BLEduino/bleduino-big-board/README.md

Big-Board
=========

The BLEduinos test board used to verify and test the individual components on the final BLEduino.
