BLEduino/bleduino-big-board/Bill of Materials/BOM_Big_Board.xlsx

Part | Part # | Leads | Total Leads | Package | Quantity | Web Links
100nF Capacitor | 445-4711-1-ND | 2 | 14 | 603 | 7 | http://www.digikey.com/product-detail/en/CL10F104ZA8NNNC/1276-1011-1-ND/3889097
10k Resistor | P10KGCT-ND | 2 | 12 | 603 | 6 | www.digikey.com/product-detail/en/ERJ-3GEYJ103V/P10KGCT-ND/134717
Ferrite Bead | MH2029-300YCT-ND | 2 | 2 | 805 | 1 | http://www.digikey.com/product-detail/en/MH2029-300Y/MH2029-300YCT-ND/3741761
ESD Protector | CG0603MLC-05E | 2 | 4 | 603 | 2 | www.digikey.com/product-detail/en/CG0603MLC-05E/CG0603MLC-05ECT-ND/3438061
1uF Capacitor | 445-5146-1-ND | 2 | 10 | 603 | 5 | www.digikey.com/product-detail/en/C1608X5R1E105K080AC/445-5146-1-ND/2093761
1k Resistor | P1.0KGCT-ND | 2 | 8 | 603 | 4 | www.digikey.com/product-detail/en/ERJ-3GEYJ102V/P1.0KGCT-ND/134874
22pF Capacitor | 445-1273-1-ND | 2 | 14 | 603 | 7 | http://www.digikey.com/product-detail/en/C1608C0G1H220J080AA/445-1273-1-ND/567670
15pF Capacitor | 399-8948-1-ND | 2 | 4 | 402 | 2 | www.digikey.com/product-detail/en/C0402C150K5GACTU/399-8948-1-ND/3522465
12pF Capacitor | 311-1016-1-ND | 2 | 4 | 402 | 2 | http://www.digikey.com/product-detail/en/CC0402JRNPO9BN120/311-1016-1-ND/302933
1nF Capacitor | 445-2651-1-ND | 2 | 2 | 402 | 1 | www.digikey.com/product-detail/en/C1005C0G1E102J050BA/445-2651-1-ND/970476
22 Ohms | P22GCT-ND | 2 | 4 | 603 | 2 | http://www.digikey.com/product-detail/en/ERJ-3GEYJ220V/P22GCT-ND/134662
22k Resistor | P22.0KLCT-ND | 2 | 2 | 402 | 1 | www.digikey.com/product-detail/en/ERJ-2RKF2202X/P22.0KLCT-ND/1746653
1.2pF Capacitor | 1276-1652-6-ND | 2 | 2 | 402 | 1 | www.digikey.com/product-detail/en/CL05C1R2BB5NNNC/1276-1652-6-ND/3892166
1.8pF Capacitor | 712-1271-1-ND | 2 | 2 | 402 | 1 | www.digikey.com/product-detail/en/500R07S1R8BV4T/712-1271-1-ND/1786733
2.2pF Capacitor | 399-7782-1-ND | 2 | 2 | 402 | 1 | www.digikey.com/product-detail/en/C0402C229C5GACTU/399-7782-1-ND/3471505
33nF Capacitor | 445-6896-1-ND | 2 | 2 | 402 | 1 | www.digikey.com/product-detail/en/CGA2B3X7R1H333K050BB/445-6896-1-ND/2672914
100nF Capacitor | 445-4965-2-ND | 2 | 4 | 402 | 2 | http://www.digikey.com/product-detail/en/C1005X5R1E104M050BC/445-4965-1-ND/2093579
10k Resistor | P10.0KLCT-ND | 2 | 6 | 402 | 3 | www.digikey.com/product-detail/en/ERJ-2RKF1002X/P10.0KLCT-ND/194119
20k Resistor | P20.0KLCT-ND | 2 | 6 | 402 | 3 | www.digikey.com/product-detail/en/ERJ-2RKF2002X/P20.0KLCT-ND/194250
3.9nH Inductor | 445-1462-1-ND | 2 | 2 | 402 | 1 | www.digikey.com/product-detail/en/MLK1005S3N9S/445-1462-1-ND/571770
8.2nH Inductor | 445-3057-1-ND | 2 | 2 | 402 | 1 | www.digikey.com/product-detail/en/MLG1005S8N2J/445-3057-1-ND/1132698
5.6nH Inductor | 445-3053-1-ND | 2 | 2 | 402 | 1 | www.digikey.com/product-detail/en/MLG1005S5N6S/445-3053-1-ND/1132694
15nH Inductor | 445-1469-1-ND | 2 | 2 | 402 | 1 | www.digikey.com/product-detail/en/MLK1005S15NJ/445-1469-1-ND/571777
10nH Inductor | 445-3059-1-ND | 2 | 2 | 402 | 1 | www.digikey.com/product-detail/en/MLG1005S10NJ/445-3059-1-ND/1132700
22uF Capacitor | 718-1139-1-ND | 2 | 4 | 1206 | 2 | www.digikey.com/product-detail/en/293D226X96R3A2TE3/718-1139-1-ND/1559633
PMOS Transistor | PMV48XP | 3 | 6 | SOT-23 | 2 | www.digikey.com/product-detail/en/PMV48XP,215/568-7579-1-ND/2744665
5V Voltage Regulator | 576-2770-1-ND | 5 | 5 | SOT-23 | 1 | http://www.digikey.com/product-detail/en/NCP1117ST50T3G/NCP1117ST50T3GOSCT-ND/1967217
3.3V Voltage Regulator | 576-1281-1-ND | 5 | 5 | SOT-23 | 1 | www.digikey.com/product-detail/en/LP2985-33DBVR/296-18476-1-ND/809911
16Mhz Oscillator Crystal | 644-1182-1-ND | 4 | 16 |  | 4 | http://www.digikey.com/product-detail/en/NX3225SA-16MHZ-STD-CSR-3/644-1181-1-ND/3125570
32Mhz Oscillator Crystal | 535-9538-1-ND | 2 | 2 |  | 1 | www.digikey.com/product-detail/en/ABS10-32.768KHZ-9-T/535-9538-1-ND/1237005
Bluetooth Low Energy- nRF8001 | 949-NRF8001-R2Q32-T | 33 | 33 | QFN-32 | 1 | www.mouser.com/ProductDetail/Nordic-Semiconductor/nRF8001-R2Q32-T/
Chip Antenna | 712-ANT-2.45-CHP-T | 2 | 2 |  | 1 | http://www.digikey.com/product-detail/en/ANT-2.45-CHP-T/ANT-2.45-CHPCT-ND/523153
ATTiny84 Microcontroller | ATTINY84A-MMHRCT-ND | 20 | 20 | QFN-20 | 1 | www.digikey.com/product-detail/en/ATTINY84A-MMHR/ATTINY84A-MMHRCT-ND/2774134
ATmega328 Microcontroller | ATMEGA328P-MURCT-ND | 32 | 32 | QFN-32 | 1 | www.digikey.com/product-detail/en/ATMEGA328P-MUR/ATMEGA328P-MURCT-ND/3440953
ATmega32u4 Microcontroller | ATMEGA32U4-MURCT-ND | 44 | 44 | QFN-44 | 1 | www.digikey.com/product-detail/en/ATMEGA32U4-MU/ATMEGA32U4-MU-ND/1914603
PTC Resettable Fuse | MF-MSMF050-2 | 2 | 2 | L1812 | 1 | www.digikey.com/product-detail/en/MF-MSMF050-2/MF-MSMF050-2CT-ND/662842
Micro USB | 609-4613-1-ND | 7 | 7 |  | 1 | www.digikey.com/product-detail/en/10118192-0001LF/609-4613-1-ND/2785378
6mm Reset Switch | CKN10246CT-ND | 4 | 4 | KMR2 | 1 | www.digikey.com/product-detail/en/KMR231NG%20LFS/CKN10246CT-ND/2176497
Diode | PESD1206Q-240CT-ND | 2 | 2 | 1206 | 1 | http://www.digikey.com/product-detail/en/CD1206-S01575/CD1206-S01575CT-ND/3741949
Yellow LED | 160-1448-1-ND | 2 | 4 | CHIPLED_0805 | 2 | www.digikey.com/product-detail/en/LTST-C191KSKT/160-1448-1-ND/386838
Green LED | 160-1446-1-ND | 2 | 2 | CHIPLED_0805 | 1 | www.digikey.com/product-detail/en/LTST-C191KGKT/160-1446-1-ND/386834
Red LED | 160-1447-1-ND | 2 | 2 | CHIPLED_0805 | 1 | www.digikey.com/product-detail/en/LTST-C191KRKT/160-1447-1-ND/386836
