BLEduino/bleduino-big-board/PDFs/BLEduino_Test_Board_brd.pdf

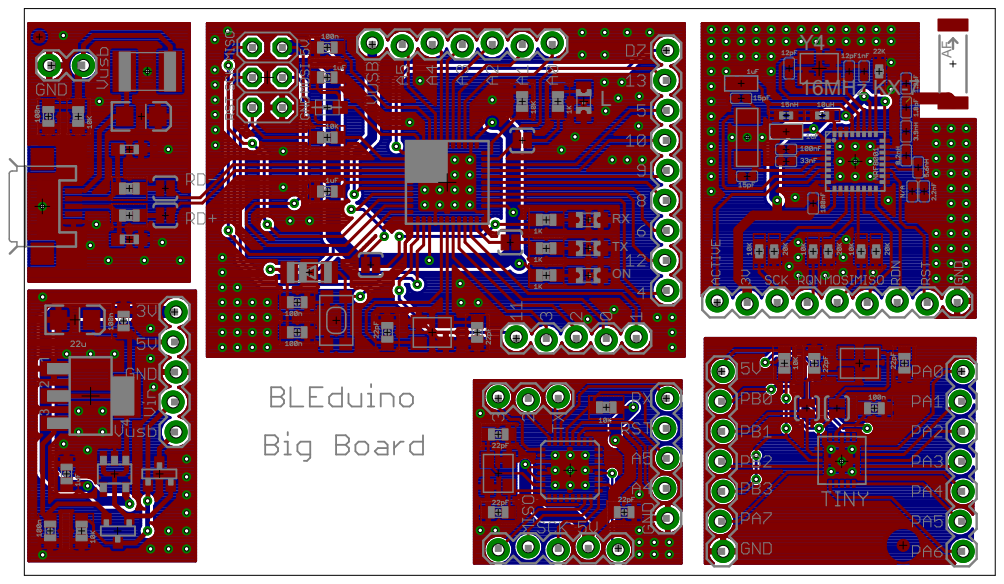
[picture p1: page 1]
