BLEduino/bleduino-big-board/PDFs/BLEduino_Test_Board_sch.pdf

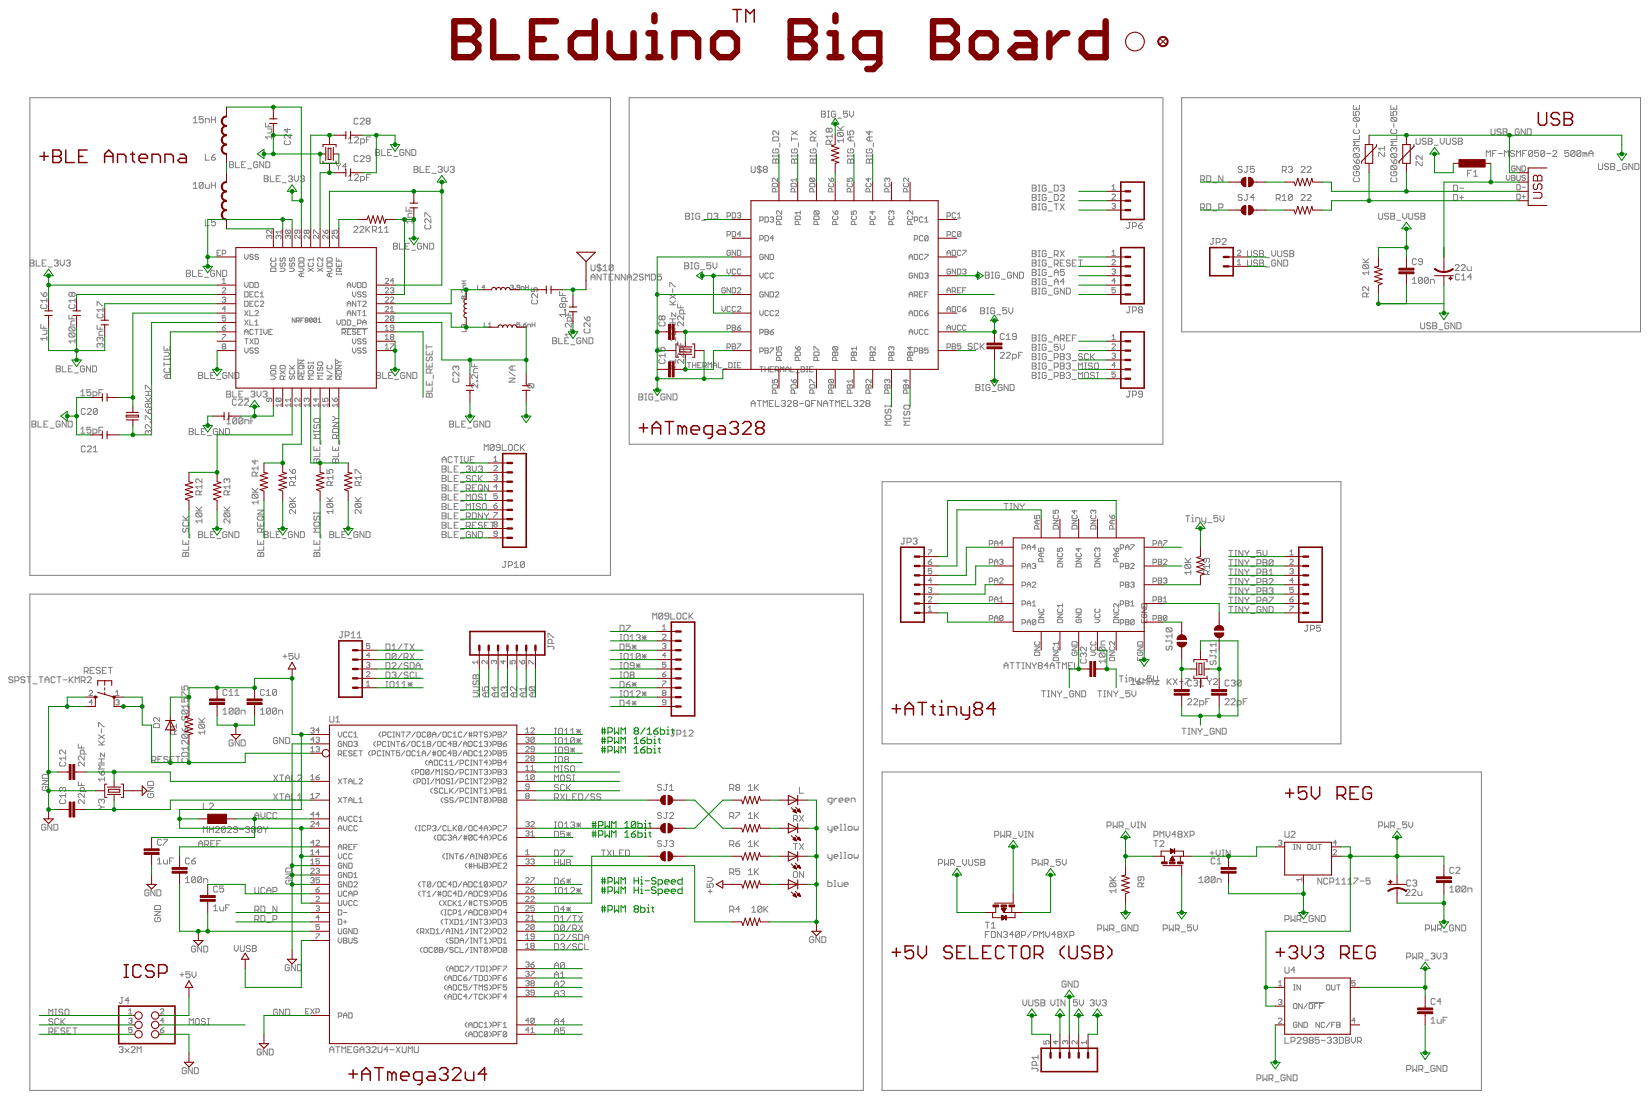
[picture p2: page 1]
