BLEduino/bleduino-big-board/Eagle/BLEduino_Test_Board.brd

## EAGLE design Eagle/BLEduino_Test_Board.brd (2013-10-08)

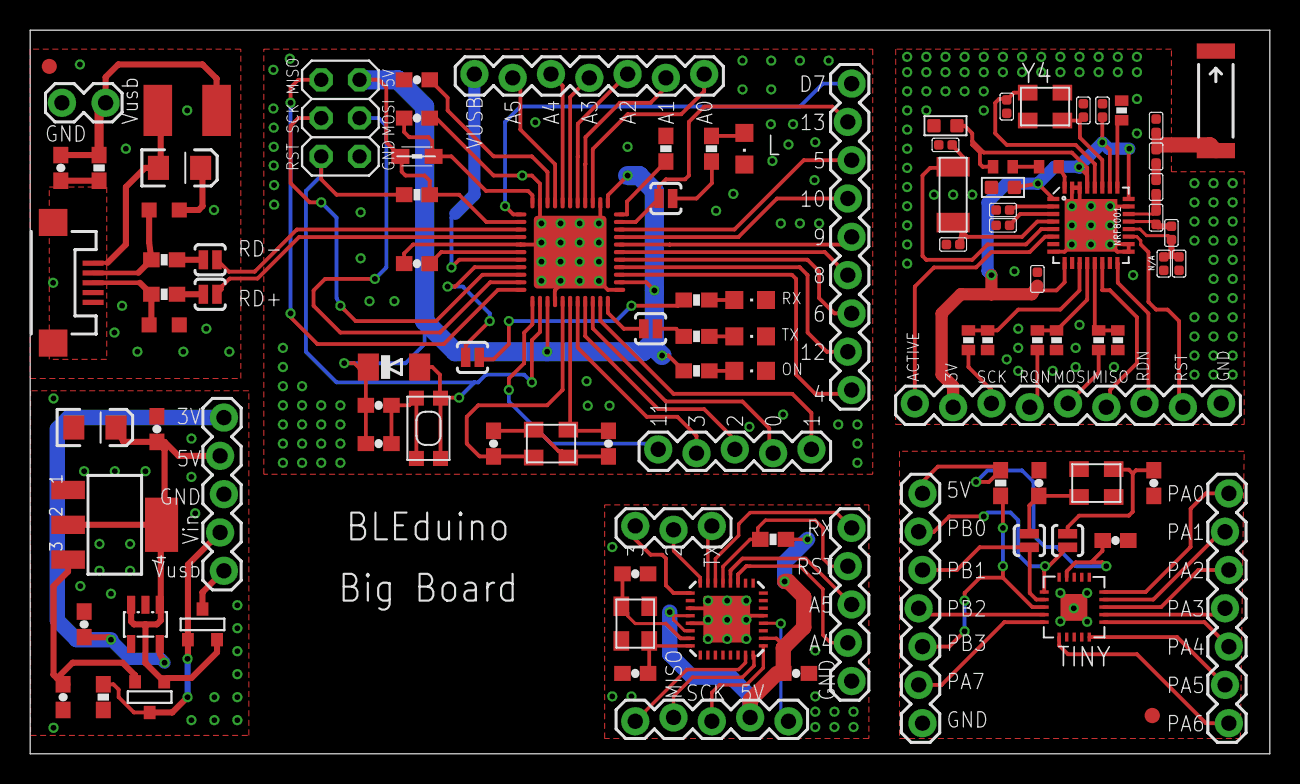
[picture p3: board BLEduino_Test_Board.brd from above]

Board: 4 copper layers, 82.2 x 48.0 mm, 103 parts (0 on the bottom side), 114 nets.

Parts:
32.768KHZ: FITNESSDEVICE_CRYSTAL-ABS10
C1, C2, C6, C9, C10, C11, C32: 100n; 0603-CAP
C3, C14: 22u; EIA3216
C4, C5, C7: 1uF; 0603-CAP
C8, C12, C13, C15, C19, C30, C31: 22pF; 0603-CAP
C16, C24: 1uF; C0603
C17: 33nF; C0402
C18, C22: 100nF; C0402
C20, C21: 15pF; C0402
C23: 2.2nF; C0402
C25: 1.8pF; C0402
C26: 1.2pF; C0402
C27: 1nF; C0402
C28, C29: 12pF; C0402
D2: CD1206-S01575; MINIMELF
F1: MF-MSMF050-2 500mA; L1812
J4: 3x2M; 2X03
JP1, JP8, JP9, JP11: 1X05_LOCK
JP2: 1X02_LOCK
JP3, JP5, JP7: 1X07_LOCK
JP6: 1X03_LOCK
JP10, JP12: M09LOCK; 1X09_LOCK
L: green; CHIPLED_0805
L1: 5.6nH; L0402
L2: MH2029-300Y; 0805
L3: 8.2nH; L0402
L4: 3.9nH; L0402
L5: 10uH; C0402
L6: 15nH; C0402
N/A: 0; C0402
NRF8001: FITNESSDEVICE_NRF8001; FITNESSDEVICE_QFN-32
ON: blue; CHIPLED_0805
R1, R2, R4, R9, R18, R19: 10K; 0603-RES
R3, R10: 22; 0603-RES
R5, R6, R7, R8: 1K; 0603-RES
R11: 22K; 0402-RES
R12, R14, R15: 10K; 0402-RES
R13, R16, R17: 20K; 0402-RES
RESET: SPST_TACT-KMR2; KMR2
RX: yellow; CHIPLED_0805
SJ1, SJ2, SJ3, SJ4, SJ5, SJ10, SJ11: SOLDERJUMPERNO; SJ_2S-NO
T1: FDN340P/PMV48XP; SOT-23
T2: PMV48XP; SOT-23
TINY: ATTINY84ATMEL; ATTINT84-QFN
TX: yellow; CHIPLED_0805
U1: ATMEGA32U4-XUMU; QFN44ML7X7
U2: NCP1117-5; LINEAR_SOT223
U4: LP2985-33DBVR; SOT23-DBV
U$8: ATMEL328-QFNATMEL328; QFN
U$10: ANTENNA2SMD5; ANTENNA-CHIP5
U$37: FIDUCIALMOUNT; FIDUCIA-MOUNT
U$53: FIDUCIAL1X2; FIDUCIAL-1X2
X1: USB-MICROB
Y1, Y2, Y3, Y4: 16MHz KX-7; CRYSTAL-3.2-2.5
Z1, Z2: CG0603MLC-05E; CT/CN0603

Connections:
+5V: C10.1, C11.1, D2.C, J4.2, L2.1, R1.1, R5.1, U1.2, U1.14, U1.24, U1.34
+VIN: C1.1, T2.2, U2.3
A0: JP7.7, U1.36
A1: JP7.6, U1.37
A2: JP7.5, U1.38
A3: JP7.4, U1.39
A4: JP7.3, U1.40
A5: JP7.2, U1.41
ACTIVE: JP10.1, NRF8001.6
AREF: C6.1, U1.42
AVCC: C7.1, L2.2, U1.44
BIG_5V: C19.1, JP9.2, R18.1, U$8.AVCC, U$8.VCC, U$8.VCC2
BIG_A4: JP8.4, U$8.PC4
BIG_A5: JP8.3, U$8.PC5
BIG_AREF: JP9.1, U$8.AREF
BIG_D2: JP6.2, U$8.PD2
BIG_D3: JP6.1, U$8.PD3
BIG_GND: C8.1, C15.1, C19.2, JP8.5, U$8.GND, U$8.GND2, U$8.GND3, U$8.THERMAL_DIE, Y1.2, Y1.4
BIG_PB3_MISO: JP9.4, U$8.PB4
BIG_PB3_MOSI: JP9.5, U$8.PB3
BIG_PB3_SCK: JP9.3, U$8.PB5
BIG_RESET: JP8.2, R18.2, U$8.PC6
BIG_RX: JP8.1, U$8.PD0
BIG_TX: JP6.3, U$8.PD1
BLE_3V3: C16.1, C22.2, C24.1, C27.1, JP10.2, L6.2, NRF8001.1, NRF8001.9, NRF8001.24, NRF8001.26, NRF8001.29
BLE_GND: C16.2, C17.2, C18.2, C20.2, C21.2, C22.1, C23.1, C24.2, C26.2, C27.2, C28.2, C29.2, JP10.9, N/A.1, NRF8001.8, NRF8001.17, NRF8001.18, NRF8001.23, NRF8001.30, NRF8001.31, NRF8001.EP, R11.2, R13.1, R16.1, R17.1, Y4.1, Y4.3
BLE_MISO: JP10.6, NRF8001.14
BLE_MOSI: JP10.5, R15.1
BLE_MOSI_SHIFTED: NRF8001.13, R15.2, R17.2
BLE_RDNY: JP10.7, NRF8001.16
BLE_REQN: JP10.4, R14.1
BLE_REQN_SHIFTED: NRF8001.12, R14.2, R16.2
BLE_RESET: JP10.8, NRF8001.19
BLE_SCK: JP10.3, R12.1
BLE_SCK_SHIFTED: NRF8001.11, R12.2, R13.2
D0/RX: JP11.4, U1.20
D1/TX: JP11.5, U1.21
D2/SDA: JP11.3, U1.19
D3/SCL: JP11.2, U1.18
D4*: JP12.9, U1.25
D5*: JP12.3, U1.31
D6*: JP12.7, U1.27
D7: JP12.1, U1.1
D+: R10.2, X1.D+, Z1.1
D-: R3.2, X1.D-, Z2.1
GND: C5.2, C6.2, C7.2, C10.2, C11.2, C12.1, C13.1, J4.6, L.C, ON.C, R4.2, RESET.2, RESET.4, RX.C, TX.C, U1.5, U1.15, U1.23, U1.35, U1.43, U1.EXP, Y3.2, Y3.4
HWB: R4.1, U1.33
IO8: JP12.6, U1.28
IO9*: JP12.5, U1.29
IO10*: JP12.4, U1.30
IO11*: JP11.1, U1.12
IO12*: JP12.8, U1.26
IO13*: JP12.2, SJ2.1, U1.32
MISO: J4.1, U1.11
MOSI: J4.4, U1.10
unnamed: R7.1, SJ1.2
unnamed: R7.2, RX.A
unnamed: ON.A, R5.2
unnamed: R6.2, TX.A
unnamed: R8.1, SJ2.2
unnamed: R6.1, SJ3.2
unnamed: L.A, R8.2
unnamed: R3.1, SJ5.2
unnamed: R10.1, SJ4.2
unnamed: C8.2, U$8.PB6, Y1.1
unnamed: C15.2, U$8.PB7, Y1.3
unnamed: C18.1, NRF8001.2
unnamed: L5.1, NRF8001.32
unnamed: C30.1, SJ11.2, Y2.3
unnamed: L5.2, L6.1
unnamed: C17.1, NRF8001.3
unnamed: 32.768KHZ.P$1, C20.1, NRF8001.4
unnamed: 32.768KHZ.P$2, C21.1, NRF8001.5
unnamed: C23.2, L1.2, N/A.2, NRF8001.20
unnamed: L3.2, L4.1, NRF8001.22
unnamed: L1.1, L3.1, NRF8001.21
unnamed: C25.2, L4.2
unnamed: C25.1, C26.1, U$10.FEED
unnamed: NRF8001.25, R11.1
unnamed: C28.1, NRF8001.28, Y4.4
unnamed: C29.1, NRF8001.27, Y4.2
unnamed: C31.1, SJ10.1, Y2.1
PWR_3V3: C4.1, JP1.1, U4.5
PWR_5V: C2.1, C3.A, JP1.2, T1.2, T2.3, U2.2, U2.4, U4.1, U4.3
PWR_GND: C1.2, C2.2, C3.C, C4.2, JP1.3, R9.1, U2.1, U4.2
PWR_VIN: JP1.4, R9.2, T1.3, T2.1
PWR_VUSB: JP1.5, T1.1
RD_N: SJ5.1, U1.3
RD_P: SJ4.1, U1.4
RESET: D2.A, J4.5, R1.2, RESET.1, RESET.3, U1.13
RXLED/SS: SJ1.1, U1.8
SCK: J4.3, U1.9
TINY_5V: C32.2, JP5.1, R19.2, TINY.VCC
TINY_GND: C30.2, C31.2, C32.1, JP5.7, TINY.EGND, TINY.GND, Y2.4
TINY_PA0: JP3.1, TINY.PA0
TINY_PA1: JP3.2, TINY.PA1
TINY_PA2: JP3.3, TINY.PA2
TINY_PA3: JP3.4, TINY.PA3
TINY_PA4: JP3.5, TINY.PA4
TINY_PA5: JP3.6, TINY.PA5
TINY_PA6: JP3.7, TINY.PA6
TINY_PA7: JP5.6, TINY.PA7
TINY_PB0: JP5.2, SJ10.2, TINY.PB0
TINY_PB1: JP5.3, SJ11.1, TINY.PB1
TINY_PB2: JP5.4, TINY.PB2
TINY_PB3: JP5.5, R19.1, TINY.PB3
TXLED: SJ3.1, U1.22
UCAP: C5.1, U1.6
USB_GND: C9.2, C14.A, JP2.1, R2.1, X1.GND, Z1.2, Z2.2
USB_VUSB: C9.1, F1.2, JP2.2, R2.2
VUSB: JP7.1, U1.7
VUSBD: C14.C, F1.1, X1.VBUS
XTAL1: C13.2, U1.17, Y3.3
XTAL2: C12.2, U1.16, Y3.1
