BLEduino/bleduino-big-board/Gerber/BLEduino_test_board2.TXT

%
M48
M72
T01C0.0150
T02C0.0374
T03C0.0400
%
T01
X1238Y780
X4138Y2480
X4738Y2580
X6038Y2780
X6038Y2180
X6038Y1580
X5438Y1580
X4738Y1580
X4838Y980
X5438Y980
X6038Y980
X2738Y3080
X2738Y4280
X2438Y4880
X1938Y4480
X3238Y4880
X3238Y5580
X2438Y5580
X4938Y6380
X4838Y7330
X3638Y7480
X2838Y7480
X2038Y7480
X4838Y8330
X7228Y8200
X7728Y8200
X8228Y8200
X8728Y8200
X8728Y7700
X8228Y7700
X7728Y7700
X7228Y7700
X7228Y8700
X7728Y8700
X8228Y8700
X8728Y8700
X8728Y9200
X8228Y9200
X7728Y9200
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
